shannu137/Thesis/data_Jun_2025/new_wheel/Analysis.pptx

## 0 deg

## 2 deg

## 4 deg

## 6 deg

## 8 deg

## 10 deg

## Average Slipratio for Wheel-v2

0 deg -> 0.207
2 deg -> 0.390
4 deg -> 0.657
6 deg -> 0.805
8 deg -> 0.837
10 deg -> 0.805

## Average Slipratio for Wheel-v1

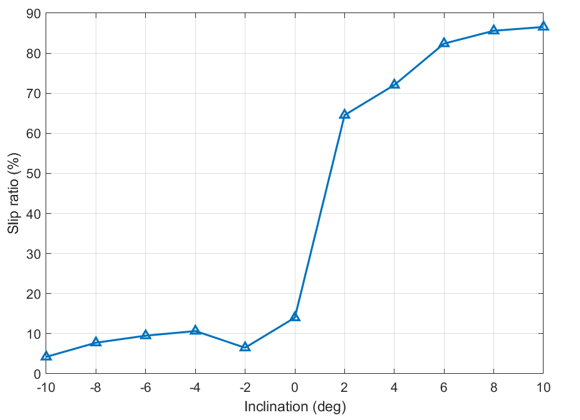
[picture p7: figure]

0 deg -> 0.135
2 deg -> 0.648
4 deg -> 0.724
6 deg -> 0.771
8 deg -> 0.806
10 deg -> 0.847
