shannu137/Thesis/SW_Testbed/sensor_specs_volt_curr.xlsx

Sensor | Quantity | Voltage | Current
Cytron Motor Driver | 3 | 5V-25V | 10A (continuous) - 30A (peak)
Johnson Motor | 6 | 12V | 7.5A
INA219 | 6 | 5V | 5mA | 30mA
Teensy Micro-controller | 2 | 5V | ~100mA | ~200mA
TCA9548A Multiplexer | 2 | 5V | 100mA | 200mA
AS5600 | 4 | 3.3V (can support 5V also) | 100mA | 400mA
IMU SmartElex 9DOF | 1 | 3.3V | 70mA | 70mA
Servo | 6 | 8.4V | 6.2A
 | 3.3V | 611mA | with 30% margin
 | 5V | 559mA
