shannu137/Thesis/SW_Testbed/optical_flow.csv

frame_number | velocity_x | velocity_y
1 | 0.0074168555 | 0.006041301
2 | -0.0014920942 | 0.0014350052
3 | -0.005337063 | 0.0058332244
4 | 0.005531667 | -0.0026308196
5 | 0.0067483163 | -0.005595006
6 | -0.0026734027 | -0.00080596143
7 | 0.004539009 | -0.00075796916
8 | -0.008693052 | -0.0005368673
9 | 0.0011223872 | 0.006953444
10 | -0.0030819236 | 0.0032837992
11 | -0.005016383 | -0.008562224
12 | 0.005270072 | 0.00051131716
13 | 0.0023588724 | 0.0044594766
14 | 0.0033568419 | -0.003661978
15 | -0.008163106 | -0.0075675035
16 | 0.004476524 | 0.0038477816
17 | -0.0005702197 | -0.0024500259
18 | 0.0011810934 | 0.010627566
19 | -0.009590522 | -0.004309468
20 | 0.0027404008 | -0.0025695295
21 | -0.0048316834 | 0.0055362284
22 | 0.0068421783 | 0.0026240353
23 | -0.013946079 | 0.0012911822
24 | -0.03017367 | 0.0053393077
25 | -0.044709574 | 0.029400552
26 | 0.5960899 | 0.03549315
27 | 5.299601 | 0.14607295
28 | 5.698839 | 0.371147
29 | 1.5077586 | 0.6525878
30 | 4.0798526 | 0.3129727
31 | 6.6240425 | 1.2050517
32 | 6.4425774 | 0.63424236
33 | 7.8483195 | 1.3951945
34 | 8.883261 | 1.123291
35 | 11.172264 | -3.1434278
36 | 11.973316 | 0.14885277
37 | 14.198208 | -0.7933853
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
