shannu137/Thesis/Communication/rover_fmeca.xlsx

Failure Mode Effects and Criticality Analysis (FMECA) |  |  |  |  |  |  |  |  |  |  |  |  |  |  |  | Severity Classification Legend |  |  | Probability Number Legend |  | CN | Frequency
Product: Planetary Rover |  |  |  | System: |  |  |  | Subsystem: Locomotion control and Communication |  |  |  |  |  | Date: 24-01-2026 | Version: v1 | Catastrophic | 4 | Loss of control, potential damage, mission abort | 1 | Very unlikely (< 0.001) | 12 | 6
Ident. Number | Item/Block | Function | Failure Mode | Failure Cause | Mission Phase / Op. Mode | Failure Effects (a. Local, b. End) | Severity Classification | Failure Detection Method | Compensating Provisions | Severity Number (SN) | Probability Number (PN) | Criticality Number (CN) | Recommendations | Remarks | Remarks on implementation | Critical | 3 | Major function loss, significant performance degradation, safety risk | 2 | Unlikely (0.001 - 0.01) | 9 | 11
COMM-001 | UART/USB Link (Teensy-Jetson) | Bidirectional telemetry and command | Complete communication loss | Cable disconnection, connector failure, EMI | ALL MODES | a. No telemetry, no commands b. Loss of control, rover immobilized | Catastrophic | Communication timeout, heartbeat loss | Watchdog triggers ESTOP on both sides | 4 | 3 | 12 | Redundant comm link, shielded cables, periodic heartbeat | Critical for slip mitigation | Periodic HB, watchdog | Marginal | 2 | Minor performance degradation, workaround available | 3 | Possible (0.01 - 0.1) | 8 | 21
COMM-002 | UART/USB Link | Bidirectional telemetry and command | Intermittent packet loss | Loose connection, EMI bursts, buffer overflow | NOMINAL, DEGRADED | a. Stale data, command dropout b. Jerky motion, incorrect slip estimation | Critical | Packet sequence number gaps, CRC failures | Retransmit, use last valid data with timeout | 3 | 4 | 12 | Implement CRC, sequence numbers, ack protocol | Affects slip calc accuracy | 1. CRC, seq nos, ack protocol 2. Retransmit last data if pkt loss | Negligible | 1 | Minimal impact, no operational effect | 4 | Likely (0.1 - 0.3) | 6 | 22
COMM-003 | UART/USB Link | Bidirectional telemetry and command | Data corruption | Bit flips, noise, baud rate mismatch | ALL MODES | a. Invalid sensor readings, wrong commands b. Erratic motor control, false slip detection | Critical | Checksum/CRC mismatch, out-of-range values | Discard corrupted packets, request retransmit | 3 | 3 | 9 | CRC-16 or higher, data validation | Can trigger false ESTOP | CRC-16/higher, discard corrupted pkt, request retransmit | Criticality Number (CN = SN × PN) |  | Higher number = Higher criticality | 5 | Very likely (> 0.3) | 10 | 3
COMM-004 | UART/USB Link | Bidirectional telemetry and command | High latency (>100ms) | CPU overload, USB stack delays, OS scheduling | NOMINAL | a. Delayed feedback b. Control lag, poor slip response | Marginal | Timestamp comparison | Increase control loop tolerance | 2 | 4 | 8 | RTOS on Teensy, real-time kernel on Jetson | Degrades slip mitigation | 1. time stamp check, if delay > threshold, latency fault flagged 2. RTOS will be implemented in next version |  |  |  |  |  | 4 | 2
COMM-005 | I2C Bus (Teensy-Current Sensors) | Read 3x current values | Bus lockup/hang | Clock stretching failure, slave not releasing SDA | NOMINAL, DEGRADED | a. Cannot read current b. No overcurrent detection, blind to motor stall | Critical | I2C timeout, bus stuck low | I2C bus reset, software recovery | 3 | 4 | 12 | Implement I2C timeout, bus recovery routine | Prevents stall detection |  |  |  |  |  |  | 3 | 1
COMM-006 | I2C Bus | Read 3x current values | Address conflict | Multiple sensors same address, PCB routing error | INIT, ALL MODES | a. Wrong sensor data read b. Incorrect current readings, false slip | Critical | Inconsistent readings, device enumeration fail | Verify addresses at boot | 3 | 2 | 6 | Verify unique I2C addresses in hardware | Design verification | Will be done during design
COMM-007 | I2C Bus | Read 3x current values | Bit errors | EMI, capacitance, long traces | NOMINAL | a. Corrupted current value b. False overcurrent or undercurrent | Marginal | Out-of-range values, checksum if available | Discard outliers, median filter | 2 | 4 | 8 | Short traces, pull-up optimization, shielding | Slip calc uses current | In Jetson check out of range for current sensor values, vel/encoder pos too
ENC-001 | Encoder (x3 per Teensy) | Measure wheel position/velocity | No signal (both channels) | Encoder failure, cable break, power loss to encoder | NOMINAL | a. Zero velocity reading b. Wheel appears stopped, false slip detection | Critical | Zero count change despite motor command | Switch to model-based estimation, DEGRADED mode | 3 | 3 | 9 | Redundant velocity estimation (current-based) | Critical for slip | If encoder failure --> meaning zero velocity despite change in motor cmd --> "DEGRADED" mode --> switch to other methods of vel estimation
ENC-002 | Encoder | Measure wheel position/velocity | Single channel failure | Partial encoder failure, A or B channel broken | NOMINAL | a. Loss of direction, reduced resolution b. Incorrect velocity, wrong slip calculation | Critical | Only one edge detected, direction ambiguity | Use single channel with last known direction | 3 | 3 | 9 | Monitor both channels, flag single-channel mode | Reduces slip accuracy | Next version
ENC-003 | Encoder | Measure wheel position/velocity | Missed counts (dropouts) | Interrupt overload, ISR too slow, debounce issues | NOMINAL, HIGH SPEED | a. Undercounted position b. Lower velocity reading, false high slip | Critical | Velocity discontinuities, acceleration limits | Limit max velocity, optimize ISR | 3 | 4 | 12 | Fast ISR, hardware quadrature decoder, DMA | Directly affects slip calc | Next version
ENC-004 | Encoder | Measure wheel position/velocity | False counts (noise) | EMI from motor PWM, poor shielding, bouncing | NOMINAL | a. Overcounted position b. Higher velocity, false low slip | Marginal | Unrealistic acceleration, velocity spikes | Digital filtering, debounce | 2 | 4 | 8 | Shielded encoder cables, RC filtering, twisted pairs | Common in PWM environment | Low Pass Filter is implemented
ENC-005 | Encoder | Measure wheel position/velocity | Phase shift/jitter | Mechanical misalignment, bearing wear, vibration | NOMINAL | a. Noisy velocity signal b. Jittery velocity, unstable slip estimate | Marginal | High velocity variance, FFT analysis | Low-pass filter, mechanical inspection | 2 | 3 | 6 | Proper encoder mounting, damping | Testbed vibration | Low Pass Filter is implemented
ENC-006 | Encoder | Measure wheel position/velocity | Mechanical decoupling | Loose set screw, shaft slip, broken coupling | NOMINAL | a. Encoder stops, wheel continues b. Zero velocity with motor running, max slip indication | Critical | Velocity drops to zero with current draw | Immediate ESTOP, mechanical inspection | 3 | 2 | 6 | Loctite on set screws, periodic inspection | Catastrophic for slip | Encoder stops, wheel moves --> ESTOP
CS-001 | Current Sensor (x3 per Teensy) | Measure motor current | No output / open circuit | Sensor failure, trace break, solder joint failure | NOMINAL | a. Zero or max reading b. No load monitoring, cannot detect stall/slip via current | Critical | Constant zero or rail value | Use voltage-based estimation, DEGRADED mode | 3 | 2 | 6 | Periodic sensor validation, redundant sensing | Stall = high slip | 1. constant zero value of current sensor --> "DEGRADED" mode 2. Think of redundancy
CS-002 | Current Sensor | Measure motor current | Offset drift | Temperature, aging, component tolerance | NOMINAL, EXTENDED OPS | a. Constant bias in reading b. Incorrect load estimation, slip calc error | Marginal | Baseline shift when motor off | Auto-zero calibration at IDLE | 2 | 4 | 8 | Auto-calibration routine, temp compensation | Lunar temp extremes | Moniter motor values when motor is off --> Auto Zero Calibration
CS-003 | Current Sensor | Measure motor current | Gain error | Wrong amplifier gain, reference voltage drift | NOMINAL | a. Scaled current reading b. Proportional error in load, slip estimation | Marginal | Cross-check with expected current model | Calibration with known loads | 2 | 3 | 6 | Factory calibration, validation test | Systematic error
CS-004 | Current Sensor | Measure motor current | Noise/spikes | PWM switching noise, inadequate filtering | NOMINAL | a. Noisy current signal b. Unstable control, false transient detection | Marginal | High frequency content in signal | Hardware RC filter, software median filter | 2 | 5 | 10 | PCB layout optimization, filtering capacitors | High PN due to PWM | Need filter for current sensor too?
CS-005 | Current Sensor | Measure motor current | Saturation | Overcurrent beyond sensor range | NOMINAL (HIGH LOAD) | a. Clipped reading b. Cannot detect true overcurrent, missed stall | Critical | Reading stuck at max | Hardware overcurrent protection on driver | 3 | 3 | 9 | Select sensor with adequate range, hardware protection | Stall during slip | Done during sensor selection
CS-006 | Current Sensor | Measure motor current | I2C communication failure (if digital sensor) | Address error, bus issue, sensor hang | NOMINAL | a. Stale/no current data b. Blind to motor load changes | Critical | I2C read timeout, NACK | I2C recovery, sensor reset | 3 | 4 | 12 | See COMM-005 mitigations | If using digital sensors | I2C read timeout, NACK --> sensor reset in next version
MD-001 | Motor Driver (x3 per Teensy) | Convert PWM to motor power | No output | Driver failure, thermal shutdown, enable pin issue | NOMINAL | a. Motor stops b. Wheel immobilized, mission abort | Critical | Zero current with PWM command | Switch to SAFE mode, diagnose other side | 3 | 2 | 6 | Thermal monitoring, enable line verification | Single wheel critical | Zero current with PWM command --> switch to SAFE mode
MD-002 | Motor Driver | Convert PWM to motor power | Stuck ON | MOSFET short, driver IC failure | NOMINAL | a. Motor runs uncontrolled b. Runaway wheel, potential damage, loss of control | Catastrophic | Current without PWM command, velocity mismatch | Hardware ESTOP, cut power via relay if available | 4 | 1 | 4 | Hardware watchdog, independent ESTOP circuit | Highest priority | Current with zero PWM, velocity mismatch between cmd vs observed --> ESTOP (check if we can stop power supply)
MD-003 | Motor Driver | Convert PWM to motor power | Reduced output / degraded | Partial MOSFET failure, overheating, voltage drop | NOMINAL | a. Lower motor power b. Reduced max velocity, asymmetric drive | Marginal | Lower velocity than commanded, higher current | Reduce speed command, thermal monitoring | 2 | 3 | 6 | Thermal sensors on drivers, derating | Gradual degradation | low velocity than commanded velocity, high current --> reduce speed cmd
MD-004 | Motor Driver | Convert PWM to motor power | PWM signal not received | Broken trace, MCU pin failure, PCB fault | NOMINAL | a. No motor control b. Wheel dead, mission abort if critical wheel | Critical | Zero velocity, zero current | Diagnose, switch to SAFE | 3 | 2 | 6 | PWM signal integrity test at INIT | PCB quality critical | zero current, zero velocity --> switch to SAFE
MD-005 | Motor Driver | Convert PWM to motor power | Direction control failure | H-bridge fault, direction pin stuck | NOMINAL | a. Wrong direction or brake b. Wheel fights command, high slip | Critical | Velocity opposite to command, high current | ESTOP, SAFE mode | 3 | 2 | 6 | Direction feedback verification | Dangerous | velocity opposite to cmd velocity, high current --> ESTOP
SERVO-001 | Servo (x3 per Teensy) | Steering/articulation control | No response | Servo failure, power loss (7.5V buck), signal issue | NOMINAL | a. Fixed steering angle b. Cannot adjust for slip, directional control loss | Critical | Angle feedback unchanged with command | Lock to safe angle, reduce speed | 3 | 2 | 6 | Angle feedback verification, power monitoring | Slip mitigation needs steering | 1. No servo feedback 2. no change in servo feedback with cmd --> lock to safe angle
SERVO-002 | Servo | Steering/articulation control | Jittering/oscillation | Noisy control signal, servo instability, mechanical binding | NOMINAL | a. Unstable angle b. Vibration, poor traction, increased slip | Marginal | High frequency angle changes, current spikes | Filter command, reduce gain | 2 | 4 | 8 | Clean PWM signal, mechanical inspection | Testbed vibration | 1. No servo feedback 2. Filter servo cmds
SERVO-003 | Servo | Steering/articulation control | Slow response | Servo overload, low voltage, mechanical resistance | NOMINAL | a. Delayed angle change b. Sluggish slip response, control lag | Marginal | Angle lags command significantly | Reduce command rate, check load | 2 | 3 | 6 | Verify servo sizing, power supply adequacy | Lunar regolith resistance | 1. No servo feedback 2. Angle lags cmd --> latency flag falagged, reduce cmd rate
SERVO-004 | Servo | Steering/articulation control | Angle feedback error | Potentiometer wear, ADC noise, calibration drift | NOMINAL | a. Wrong angle reading b. Incorrect steering, poor slip compensation | Marginal | Angle mismatch with expected, cross-check with other sensors | Recalibration routine | 2 | 4 | 8 | Periodic calibration, analog filtering | Analog signal vulnerable | 1. No servo feedback 2. angle mismatch, check with other sensors --> SAFE
SERVO-005 | Servo | Steering/articulation control | Mechanical jam | Foreign object, gear failure, bearing seizure | NOMINAL | a. Servo stalled, high current b. Fixed angle, loss of steering control | Critical | High servo current, no angle change | ESTOP, clear obstruction | 3 | 2 | 6 | Mechanical protection, current monitoring | Testbed debris
MOTOR-001 | DC Motor (x3 per Teensy) | Drive wheels | Winding open circuit | Brush wear, winding failure, connection break | NOMINAL | a. No rotation b. Wheel dead, asymmetric drive, high slip on other wheels | Critical | Zero velocity with current command, no current draw | Compensate with other wheels, DEGRADED mode | 3 | 2 | 6 | Brush inspection, connection integrity | Wear item | Nonzero cmd, zero current and velocity --> DEGRADED mode
MOTOR-002 | DC Motor | Drive wheels | Winding short circuit | Insulation failure, overheating | NOMINAL | a. High current, low torque b. Overcurrent trip, wheel ineffective | Critical | Very high current, low velocity | Current limit, thermal shutdown | 3 | 1 | 3 | Thermal protection, current limiting | Overheat in stall | High current, low velocity --> SAFE mode
MOTOR-003 | DC Motor | Drive wheels | Bearing seizure | Contamination, wear, lack of lubrication | NOMINAL | a. Motor stalls b. Wheel locked, high slip, potential damage | Critical | High current, zero velocity | ESTOP, mechanical inspection | 3 | 2 | 6 | Sealed bearings, periodic maintenance | Lunar dust | High current, zero velocity --> ESTOP
MOTOR-004 | DC Motor | Drive wheels | Reduced efficiency | Brush wear, bearing friction, magnet degradation | NOMINAL | a. Higher current for same speed b. Reduced performance, thermal issues | Marginal | Current increase over time for same velocity | Adjust control parameters, plan maintenance | 2 | 4 | 8 | Performance monitoring, predictive maintenance | Gradual degradation
MOTOR-005 | DC Motor | Drive wheels | Mechanical decoupling from wheel | Gearbox failure, shaft break, coupling failure | NOMINAL | a. Motor spins, wheel doesn't b. Zero traction, max slip, mission abort | Catastrophic | High velocity reading (encoder on motor side) with no rover motion | Immediate ESTOP | 4 | 1 | 4 | Robust mechanical design, periodic inspection | Catastrophic failure | High velocity, no rover movement --> ESTOP
MCU-001 | Teensy MCU | Control loop, sensor interface, communication | Complete failure | Power loss, firmware crash, hardware failure | ALL MODES | a. No control, no telemetry b. Half rover dead (3 wheels), mission abort | Catastrophic | No heartbeat, no telemetry | Jetson detects timeout, ESTOP, use other Teensy if possible | 4 | 2 | 8 | Watchdog timer, redundant Teensy, robust power | Critical single point | No HB or telemetry --> ESTOP (/ DEGRADED)
MCU-002 | Teensy MCU | Control loop execution | Firmware hang/deadlock | Software bug, infinite loop, resource contention | NOMINAL | a. Control stops b. Motors continue last command until watchdog | Critical | Telemetry stops, heartbeat loss | Watchdog reset, ESTOP | 3 | 3 | 9 | Watchdog timer, defensive programming, testing | Software quality critical | Use watchdog to check no deadlocks
MCU-003 | Teensy MCU | Interrupt handling | Interrupt overload | Too many encoder edges, high PWM frequency | NOMINAL (HIGH SPEED) | a. Missed interrupts, slow response b. Inaccurate encoder counts, control lag | Marginal | Increased loop time, missed counts | Reduce interrupt frequency, optimize ISR | 2 | 4 | 8 | Hardware quadrature decoder, DMA, profiling | High speed issue
MCU-004 | Teensy MCU | ADC conversion (servo feedback) | ADC failure | Hardware fault, reference voltage issue | NOMINAL | a. Invalid servo angle readings b. Incorrect steering control | Critical | Constant or erratic ADC values | Use commanded angle (open loop), DEGRADED | 3 | 2 | 6 | ADC self-test at INIT, reference monitoring | Servo feedback lost | Already added
MCU-005 | Teensy MCU | PWM generation | PWM output failure | Timer failure, pin configuration error | NOMINAL | a. No motor control b. Wheels dead, mission abort | Catastrophic | No motor response, zero current | SAFE mode, diagnose | 4 | 2 | 8 | PWM self-test at INIT, redundant timers | Critical function | Already added
MCU-006 | Teensy MCU | Memory corruption | Bit flip (radiation), buffer overflow, wild pointer | Radiation in space | ALL MODES | a. Unpredictable behavior b. Erratic control, potential damage | Critical | Checksum failure, invalid values, watchdog | Memory protection, ECC if available, watchdog | 3 | 2 | 6 | Code review, static analysis, memory bounds checking |  | Already added
CTRL-001 | PI Controller | Motor velocity control | Integral windup | Sustained error, saturation, long startup | INIT, NOMINAL | a. Overshoot, oscillation b. Unstable motion, poor slip control | Marginal | Large overshoot, oscillation in velocity | Anti-windup, integrator clamping | 2 | 4 | 8 | Implement anti-windup, conditional integration | Common PI issue | Anti-windup in PI controller
CTRL-002 | PI Controller | Motor velocity control | Tuning instability | Wrong gains, load changes, surface variation | NOMINAL | a. Oscillation or sluggish response b. Poor velocity tracking, inaccurate slip | Marginal | Velocity oscillation, steady-state error | Adaptive tuning, gain scheduling | 2 | 4 | 8 | Systematic tuning procedure, field testing | Lunar surface variation | Adaptive gains in PI controller
CTRL-003 | PI Controller | Motor velocity control | Feedforward mismatch | Incorrect model, load estimation error | NOMINAL | a. Tracking error b. Velocity lag, slip calculation error | Marginal | Persistent tracking error | Update feedforward model | 2 | 4 | 8 | Model identification, online adaptation | Model-based component | Adaptive feedforward gain
CTRL-004 | Low-Pass Filter | Velocity filtering | Cutoff too low | Conservative design, wrong parameter | NOMINAL | a. Excessive phase lag b. Delayed slip detection, slow response | Marginal | Lagging velocity signal | Increase cutoff frequency | 2 | 3 | 6 | Filter design analysis, frequency response testing | Trade-off: noise vs lag | During filter design, note this
CTRL-005 | Low-Pass Filter | Velocity filtering | Cutoff too high | Aggressive design, wrong parameter | NOMINAL | a. Noisy velocity signal b. Noisy slip estimate, false alarms | Marginal | High frequency noise in output | Decrease cutoff frequency | 2 | 3 | 6 | Filter design analysis, noise characterization | Trade-off: noise vs lag | During filter design, note this
CTRL-006 | Control Loop | Overall velocity control | Loop timing jitter | OS scheduling, interrupt latency, CPU load | NOMINAL | a. Inconsistent control update b. Degraded performance, instability | Marginal | Variable loop period | RTOS, priority management | 2 | 4 | 8 | Real-time OS, dedicated core, profiling | Jetson timing
PCB-001 | PCB Interconnects | Electrical connections | Solder joint failure | Thermal cycling, vibration, poor soldering | NOMINAL | a. Intermittent connection b. Erratic behavior, intermittent failures | Critical | Intermittent sensor readings, random resets | Conformal coating, robust soldering | 3 | 3 | 9 | IPC standards, inspection, conformal coating | Vibration in testbed
PCB-002 | PCB Traces | Signal routing | Trace break | Mechanical stress, manufacturing defect | ALL MODES | a. Open circuit b. Component non-functional | Critical | Component failure symptoms | Redundant traces if critical | 3 | 2 | 6 | Proper PCB design, stress relief, inspection | Manufacturing quality
PCB-003 | PCB | Ground plane | Ground loop / poor grounding | Layout error, multiple ground points | NOMINAL | a. Noise injection b. Sensor noise, communication errors | Marginal | Unexplained noise, EMI issues | Star grounding, ground plane optimization | 2 | 4 | 8 | Proper PCB layout, ground plane design | Common EMI issue
PCB-004 | PCB | Power distribution | Voltage drop | Thin traces, high current, long traces | NOMINAL | a. Reduced voltage at component b. Component malfunction, brownout | Marginal | Voltage monitoring, brownout detection | Wider traces, separate power planes | 2 | 3 | 6 | Power integrity analysis, adequate trace width | High current paths
PCB-005 | PCB Connectors | Mechanical/electrical interface | Connector loosening | Vibration, thermal cycling, poor retention | NOMINAL | a. Intermittent connection b. Random failures, intermittent behavior | Critical | Intermittent failures correlated with motion | Locking connectors, strain relief, adhesive | 3 | 4 | 12 | Locking connectors, periodic inspection | High vibration
PCB-006 | PCB | ESD protection | ESD damage | Handling, dry environment, no protection | INIT, DIAGNOSTIC | a. Component damage b. Permanent failure | Critical | Component failure after handling | ESD protection devices, handling procedures | 3 | 2 | 6 | ESD protection, handling protocols | Preventive
ALGO-001 | Slip Estimation Algorithm | Calculate wheel slip | Incorrect slip calculation | Wrong formula, sensor fusion error, calibration | NOMINAL | a. Wrong slip value b. Ineffective slip mitigation, false alarms | Critical | Slip value doesn't match observed behavior | Algorithm validation, ground truth comparison | 3 | 3 | 9 | Extensive testing, validation with known conditions | Core mission function | After implementing slip control techniques
ALGO-002 | Slip Estimation Algorithm | Calculate wheel slip | Division by zero | Zero velocity reference, edge case | NOMINAL (LOW SPEED) | a. NaN or infinite slip b. Algorithm crash, control failure | Critical | Math exception, invalid values | Bounds checking, minimum threshold | 3 | 3 | 9 | Defensive programming, edge case testing | Low speed vulnerability | After implementing slip control techniques
ALGO-003 | Slip Mitigation Strategy | Adjust control for slip | Ineffective response | Wrong strategy, insufficient authority, delay | NOMINAL | a. Slip continues b. Mission inefficiency, potential immobilization | Marginal | Persistent high slip despite mitigation | Strategy refinement, increased authority | 2 | 4 | 8 | Field testing, strategy optimization | Algorithm effectiveness | After implementing slip control techniques
ALGO-004 | Slip Mitigation Strategy | Adjust control for slip | Overcorrection | Too aggressive, wrong gains | NOMINAL | a. Oscillation, instability b. Jerky motion, increased slip | Marginal | Hunting behavior, oscillation | Reduce gains, add damping | 2 | 4 | 8 | Tuning, stability analysis | Stability issue | After implementing slip control techniques
SYS-001 | Left-Right Symmetry | Independent 3-wheel control | Asymmetric failure | One Teensy fails, one side degraded | NOMINAL | a. One side functional, other not b. Rover turns, cannot go straight | Critical | Telemetry from only one Teensy | Jetson compensates with differential control if possible | 3 | 2 | 6 | Redundancy strategy, cross-side compensation | System-level | ESTOP (/ DEGRADED)
SYS-002 | Jetson | High-level control, telemetry processing | Jetson crash/hang | Software bug, OS issue, resource exhaustion | NOMINAL | a. No high-level control b. Teensys continue last command until timeout, then ESTOP | Critical | No commands from Jetson, external monitoring | Teensy watchdog triggers ESTOP | 3 | 3 | 9 | Jetson watchdog, robust software, monitoring | System-level | No cmds from Jetson --> ESTOP
SYS-003 | Jetson | Command generation | Incorrect commands | Software bug, sensor fusion error | NOMINAL | a. Wrong motor/servo commands b. Erratic motion, potential damage | Critical | Unexpected rover behavior, safety bounds violation | Sanity checks on Teensy, rate limiting | 3 | 3 | 9 | Software validation, bounds checking on both sides | Software quality | Bounds check
SYS-004 | Overall System | Slip estimation and mitigation | Sensor data synchronization error | Different sample rates, timing jitter, latency | NOMINAL | a. Misaligned sensor data b. Incorrect slip calculation, phase errors | Marginal | Timestamp analysis, correlation issues | Timestamp all data, synchronization protocol | 2 | 4 | 8 | Time synchronization, consistent sampling | Multi-sensor fusion
SYS-005 | Overall System | State machine transitions | Incorrect mode transition | Logic error, race condition, unexpected event | ALL MODES | a. Stuck in wrong mode b. Inappropriate behavior for situation | Critical | Mode doesn't match expected, telemetry monitoring | Watchdog, manual override | 3 | 3 | 9 | State machine validation, formal verification | Safety-critical
SYS-006 | Overall System | Emergency stop | ESTOP not triggered when needed | Detection failure, logic error, hardware fault | NOMINAL | a. Unsafe condition continues b. Potential damage, mission failure | Catastrophic | External observation, post-incident analysis | Multiple ESTOP triggers, hardware watchdog | 4 | 2 | 8 | Redundant ESTOP paths, independent hardware watchdog | Safety-critical
SYS-007 | Overall System | Emergency stop | False ESTOP trigger | Sensor noise, wrong threshold, software bug | NOMINAL | a. Unnecessary stop b. Mission interruption, efficiency loss | Marginal | Frequent ESTOP without real hazard | Adjust thresholds, debouncing | 2 | 4 | 8 | Threshold tuning, false alarm analysis | Nuisance vs safety
ENV-001 | All Sensors/Components | Normal operation | Lunar dust contamination | Fine regolith particles, testbed simulation | NOMINAL (EXTENDED) | a. Encoder fouling, connector issues b. Degraded performance, failures | Marginal | Performance degradation over time | Sealed components, periodic cleaning | 2 | 5 | 10 | Dust mitigation, sealed enclosures | Testbed simulation
ENV-002 | All Components | Normal operation | Temperature extremes | Testbed thermal cycling simulation | ALL MODES | a. Component out of spec b. Failures, performance degradation | Marginal | Temperature monitoring, component behavior | Thermal management, component selection | 2 | 4 | 8 | Temperature sensors, thermal design | Lunar environment
ENV-003 | All Electrical | Normal operation | Vibration | Testbed motion, mechanical coupling | NOMINAL | a. Connector loosening, solder fatigue b. Intermittent failures | Marginal | Intermittent issues during motion | Vibration damping, robust connections | 2 | 5 | 10 | Vibration isolation, robust design | Testbed characteristic
