shannu137/Thesis/Kinematics_Simulink/Rover URDF 2/meshes/trl.STL

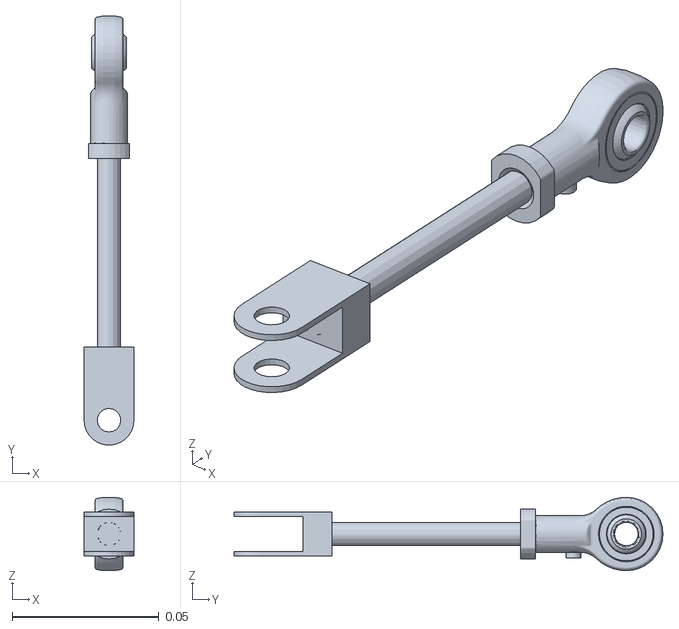
[picture p8: CAD file, 2025-11-26]
Kinematics_Simulink/Rover URDF 2/meshes/trl.STL
0.017 x 0.146 x 0.025
