shannu137/Thesis/Kinematics_Simulink/Rover URDF 2/meshes/k4.STL

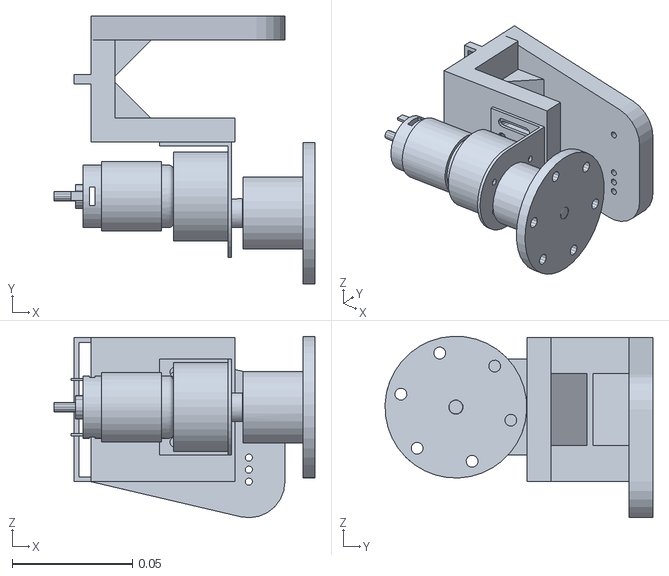
[picture p9: CAD file, 2025-11-26]
Kinematics_Simulink/Rover URDF 2/meshes/k4.STL
0.109 x 0.111 x 0.0755
