shannu137/Thesis/Kinematics_Simulink/Rover URDF 2/meshes/k5.STL

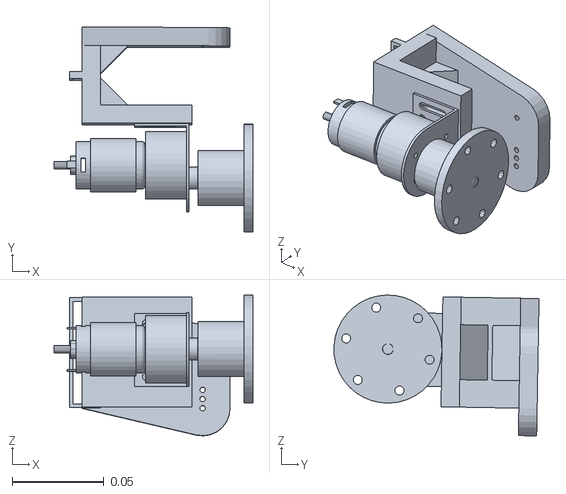
[picture p10: CAD file, 2025-11-26]
Kinematics_Simulink/Rover URDF 2/meshes/k5.STL
0.109 x 0.112 x 0.0769
