shannu137/Thesis/Kinematics_Simulink/Rover URDF 2/meshes/br.STL

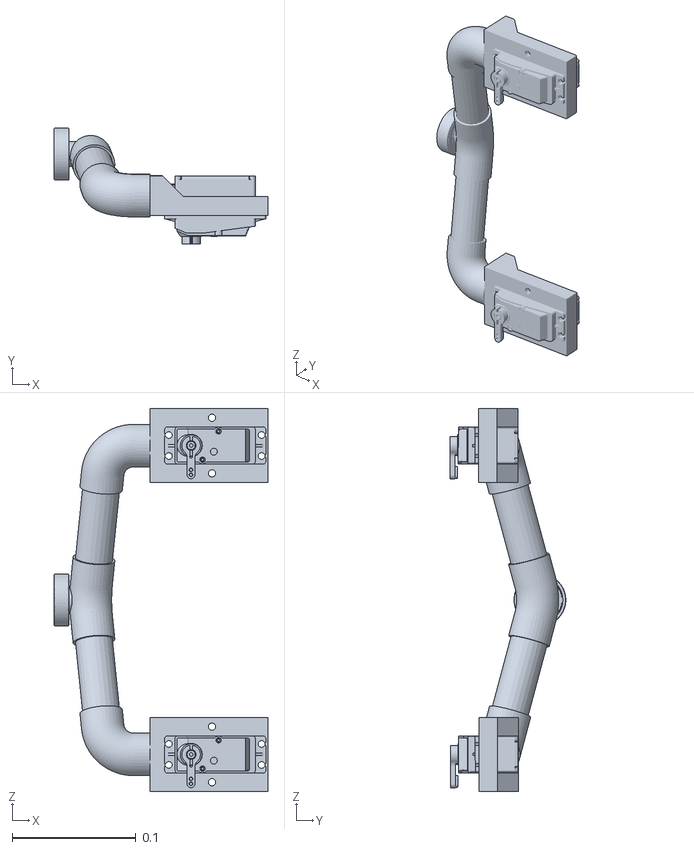
[picture p11: CAD file, 2025-11-26]
Kinematics_Simulink/Rover URDF 2/meshes/br.STL
0.173 x 0.0937 x 0.31
