shannu137/Thesis/Kinematics_Simulink/Rover URDF 2/meshes/base_link.STL

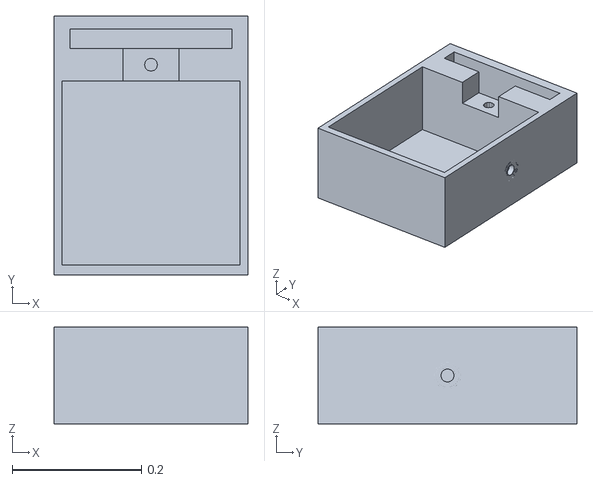
[picture p12: CAD file, 2025-11-26]
Kinematics_Simulink/Rover URDF 2/meshes/base_link.STL
0.3 x 0.4 x 0.15
