shannu137/Thesis/Kinematics_Simulink/Rover URDF 2/meshes/w5.STL

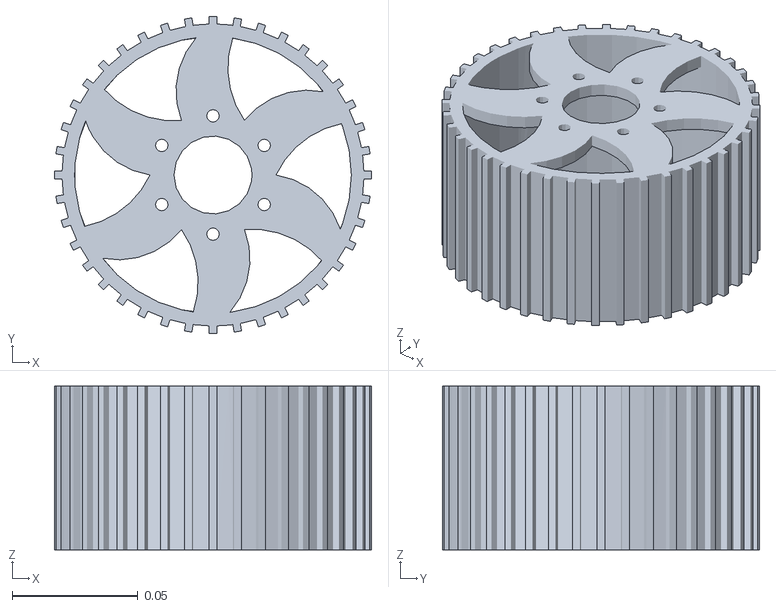
[picture p13: CAD file, 2025-11-26]
Kinematics_Simulink/Rover URDF 2/meshes/w5.STL
0.126 x 0.126 x 0.065
