shannu137/Thesis/Kinematics_Simulink/Rover URDF 2/meshes/l.STL

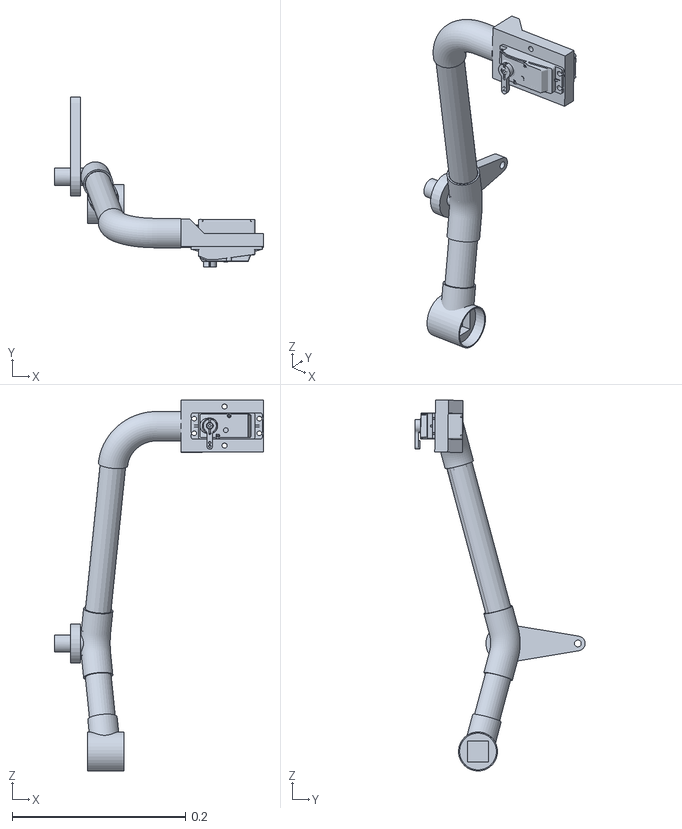
[picture p14: CAD file, 2025-11-26]
Kinematics_Simulink/Rover URDF 2/meshes/l.STL
0.241 x 0.196 x 0.428
