shannu137/Thesis/Kinematics_Simulink/Rover URDF 2/meshes/k1.STL

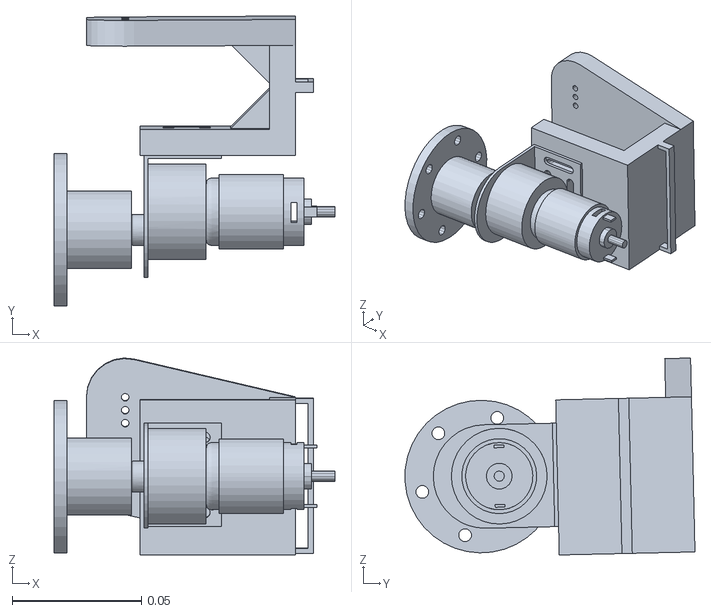
[picture p15: CAD file, 2025-11-26]
Kinematics_Simulink/Rover URDF 2/meshes/k1.STL
0.109 x 0.112 x 0.0762
