shannu137/Thesis/Kinematics_Simulink/Rover URDF 2/meshes/df.STL

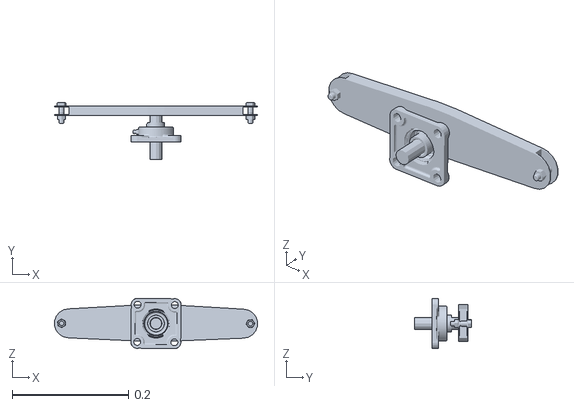
[picture p16: CAD file, 2025-11-26]
Kinematics_Simulink/Rover URDF 2/meshes/df.STL
0.349 x 0.0975 x 0.0867
