shannu137/Thesis/(list of files, cad)

Other CAD files:
Kinematics_Simulink/Rover URDF 2/meshes/trr.STL
Kinematics_Simulink/Rover URDF 2/meshes/k6.STL
Kinematics_Simulink/Rover URDF 2/meshes/k3.STL
Kinematics_Simulink/Rover URDF 2/meshes/bl.STL
Kinematics_Simulink/Rover URDF 2/meshes/w3.STL
Kinematics_Simulink/Rover URDF 2/meshes/w4.STL
Kinematics_Simulink/Rover URDF 2/meshes/r .STL
Kinematics_Simulink/Rover URDF 2/meshes/k2.STL
Kinematics_Simulink/Rover URDF 2/meshes/w1.STL
Kinematics_Simulink/Rover URDF 2/meshes/w6.STL
Kinematics_Simulink/Rover URDF 2/meshes/w2.STL
