shannu137/Thesis/data_Jun_2025/new_wheel/Analysis.pdf

# 0 deg

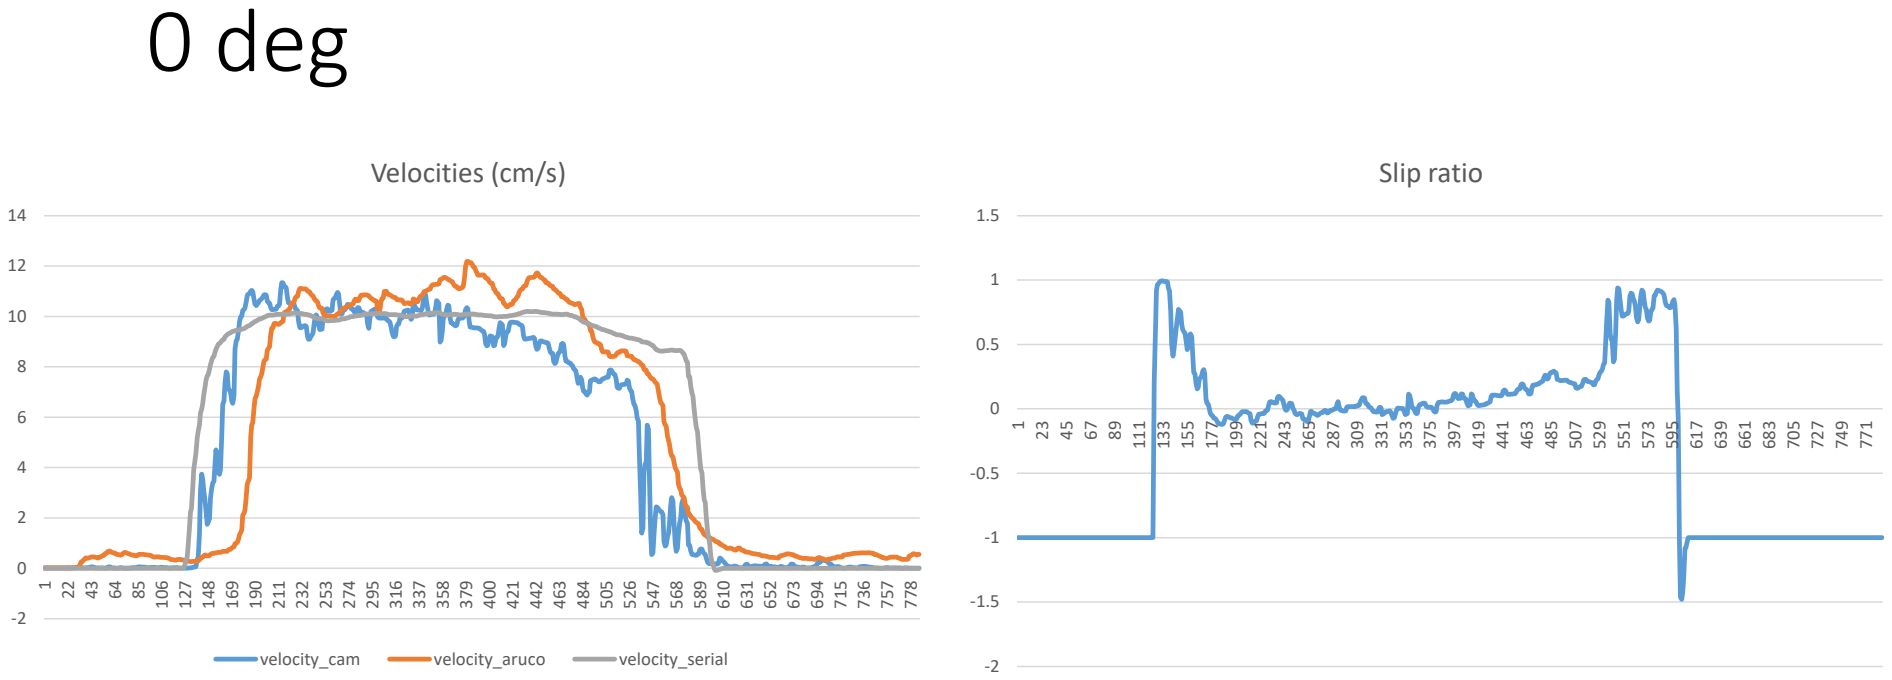
[picture p17: page 1]
Velocities (cm/s); velocity_cam; velocity_aruco; velocity_serial; Slip ratio

# 2 deg

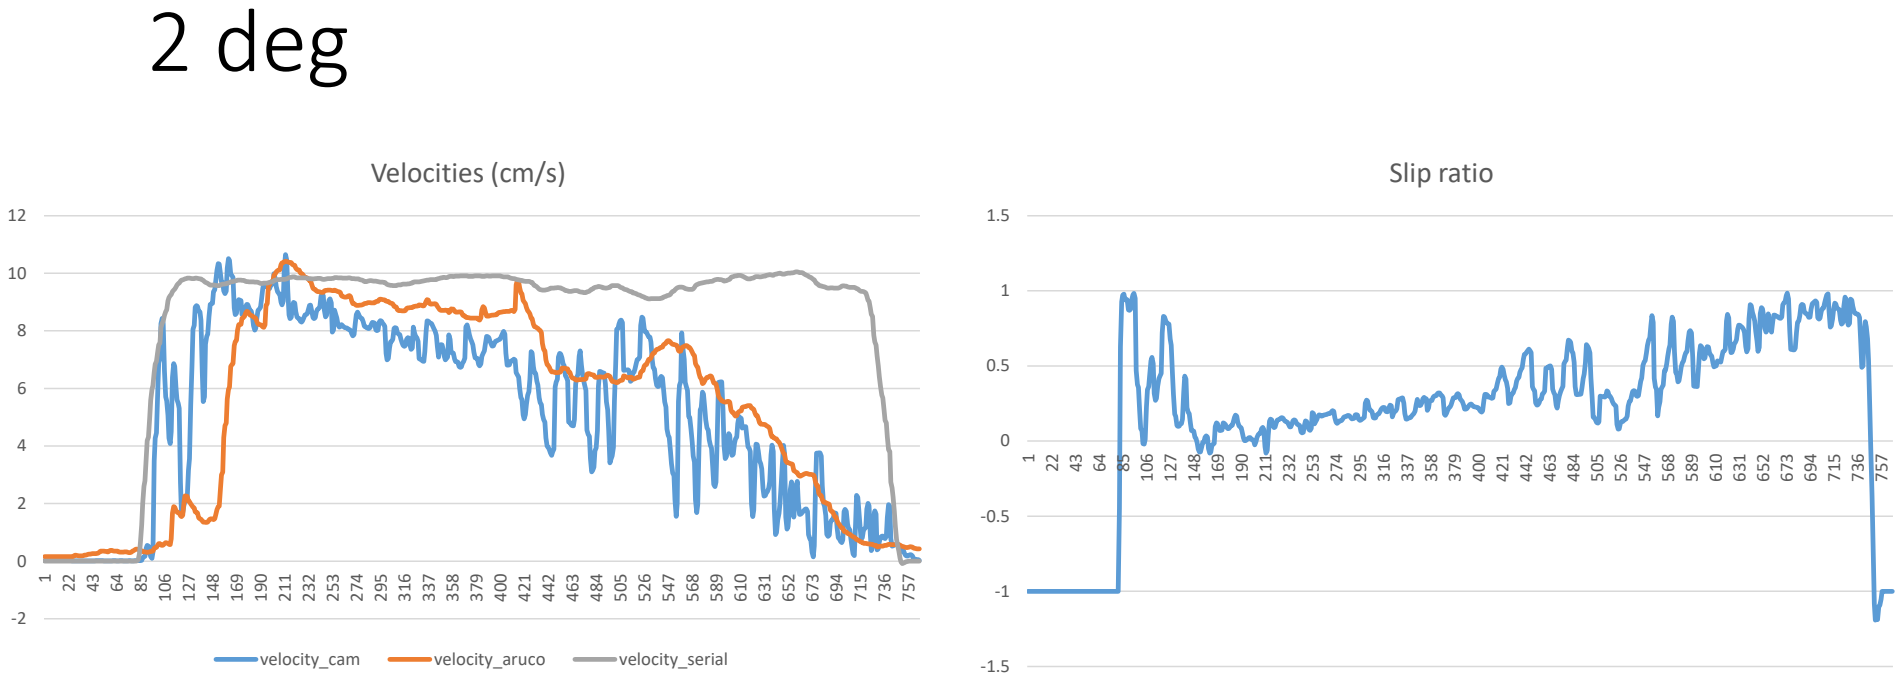
[picture p18: page 2]
Velocities (cm/s); velocity_cam; velocity_aruco; velocity_serial; Slip ratio

# 4 deg

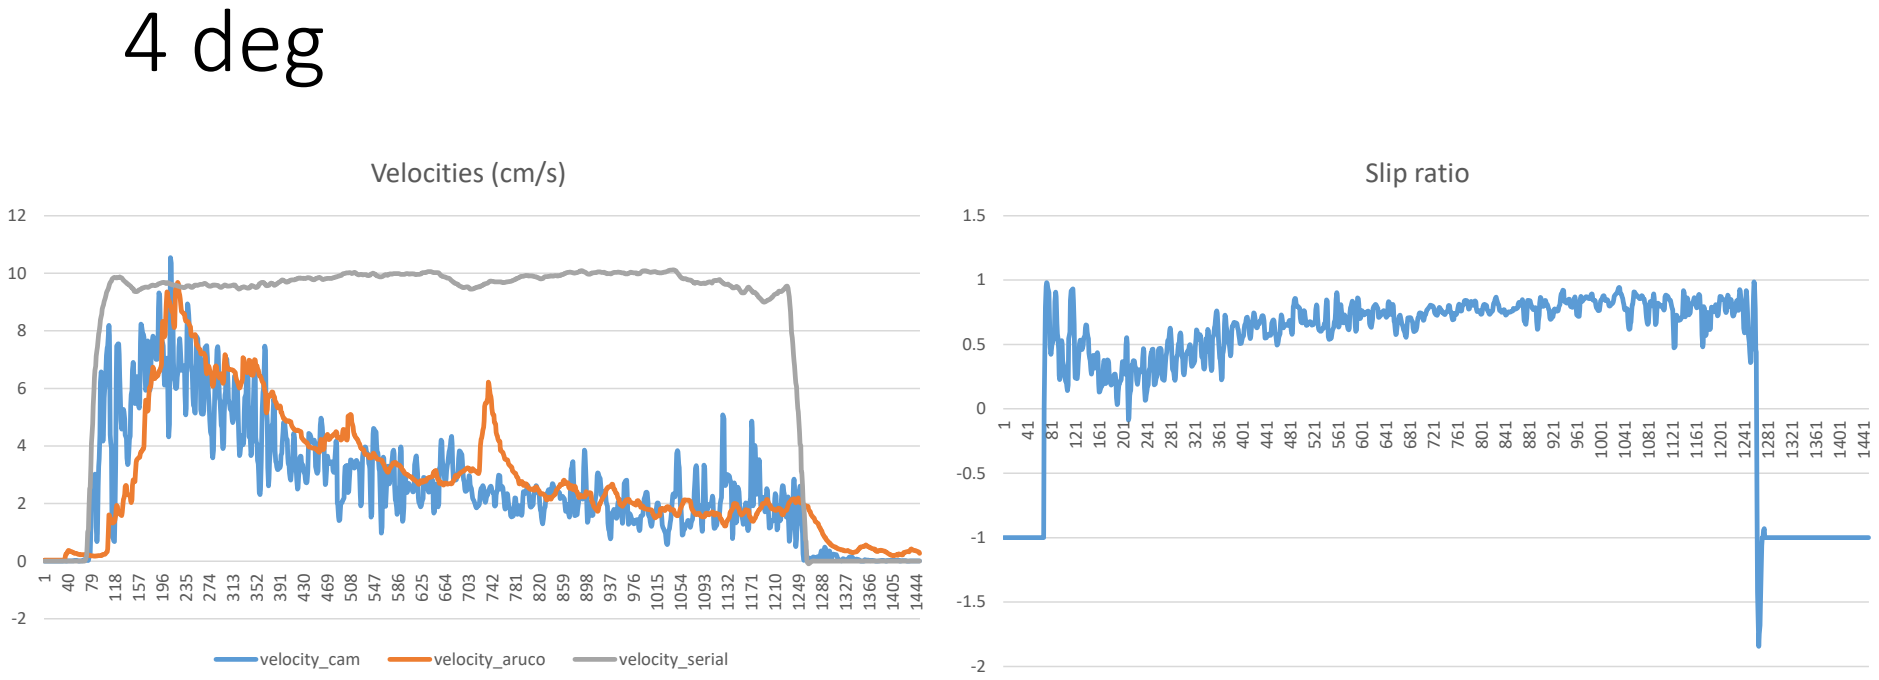
[picture p19: page 3]
Velocities (cm/s); velocity_cam; velocity_aruco; velocity_serial; Slip ratio

# 6 deg

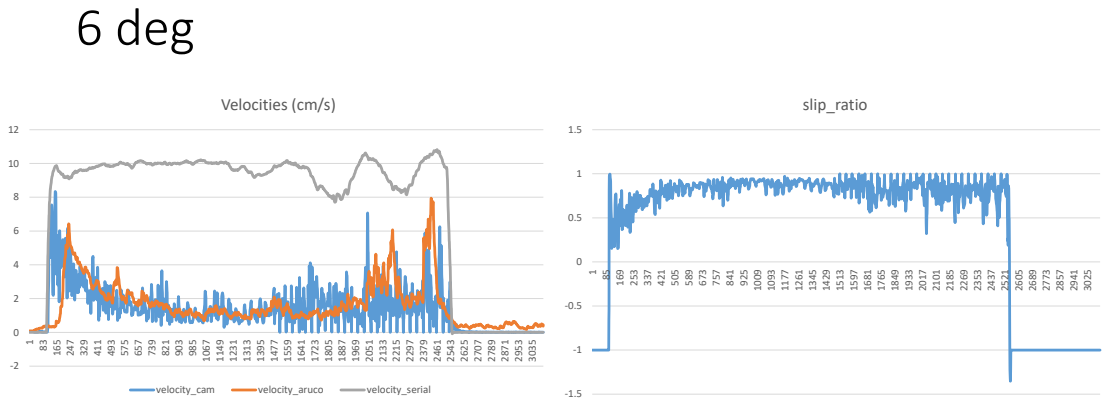
[picture p20: page 4]
Velocities (cm/s); velocity_cam; velocity_aruco; velocity_serial; slip_ratio

# 8 deg

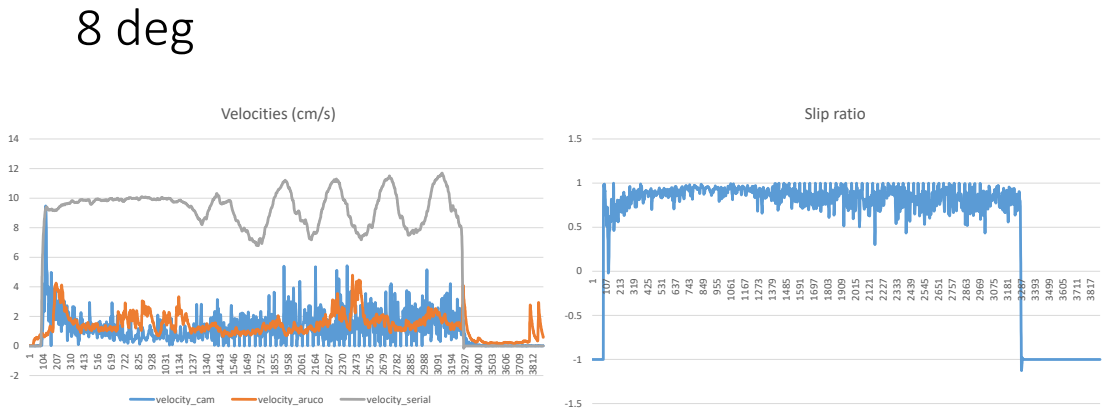
[picture p21: page 5]
Velocities (cm/s); velocity_cam; velocity_aruco; velocity_serial; Slip ratio

# 10 deg

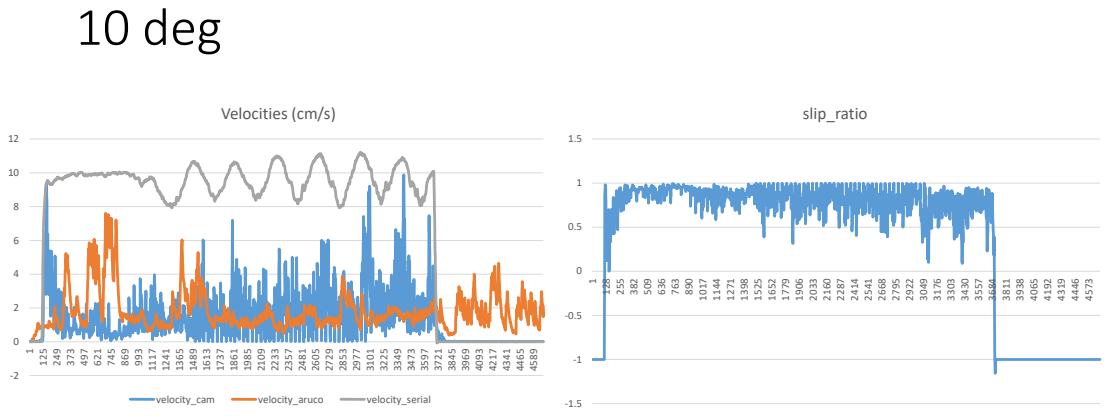
[picture p22: page 6]
Velocities (cm/s); velocity_cam; velocity_aruco; velocity_serial; slip_ratio

# Average Slipratio

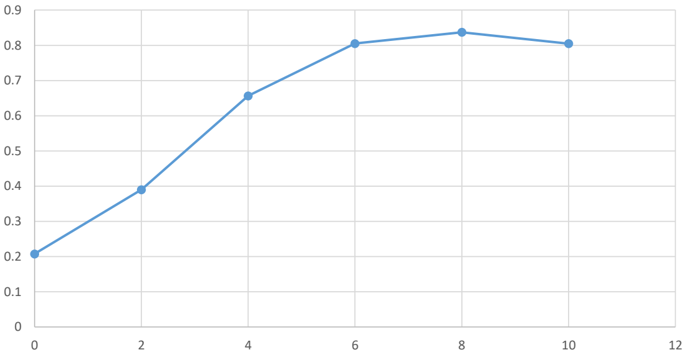
[picture p23: figure]

# 0 deg -> 0.207447 2 deg -> 0.389852 4 deg -> 0.656637 6 deg -> 0.805145 8 deg -> 0.837180 10 deg -> 0.805028

## Slip ratio vs Inclination
