shannu137/Thesis/Single_Wheel_Board_Updated/Single_Wheel_Board.kicad_pcb

## KiCad design Single_Wheel_Board_Updated/Single_Wheel_Board.kicad_pcb (2025-11-26)

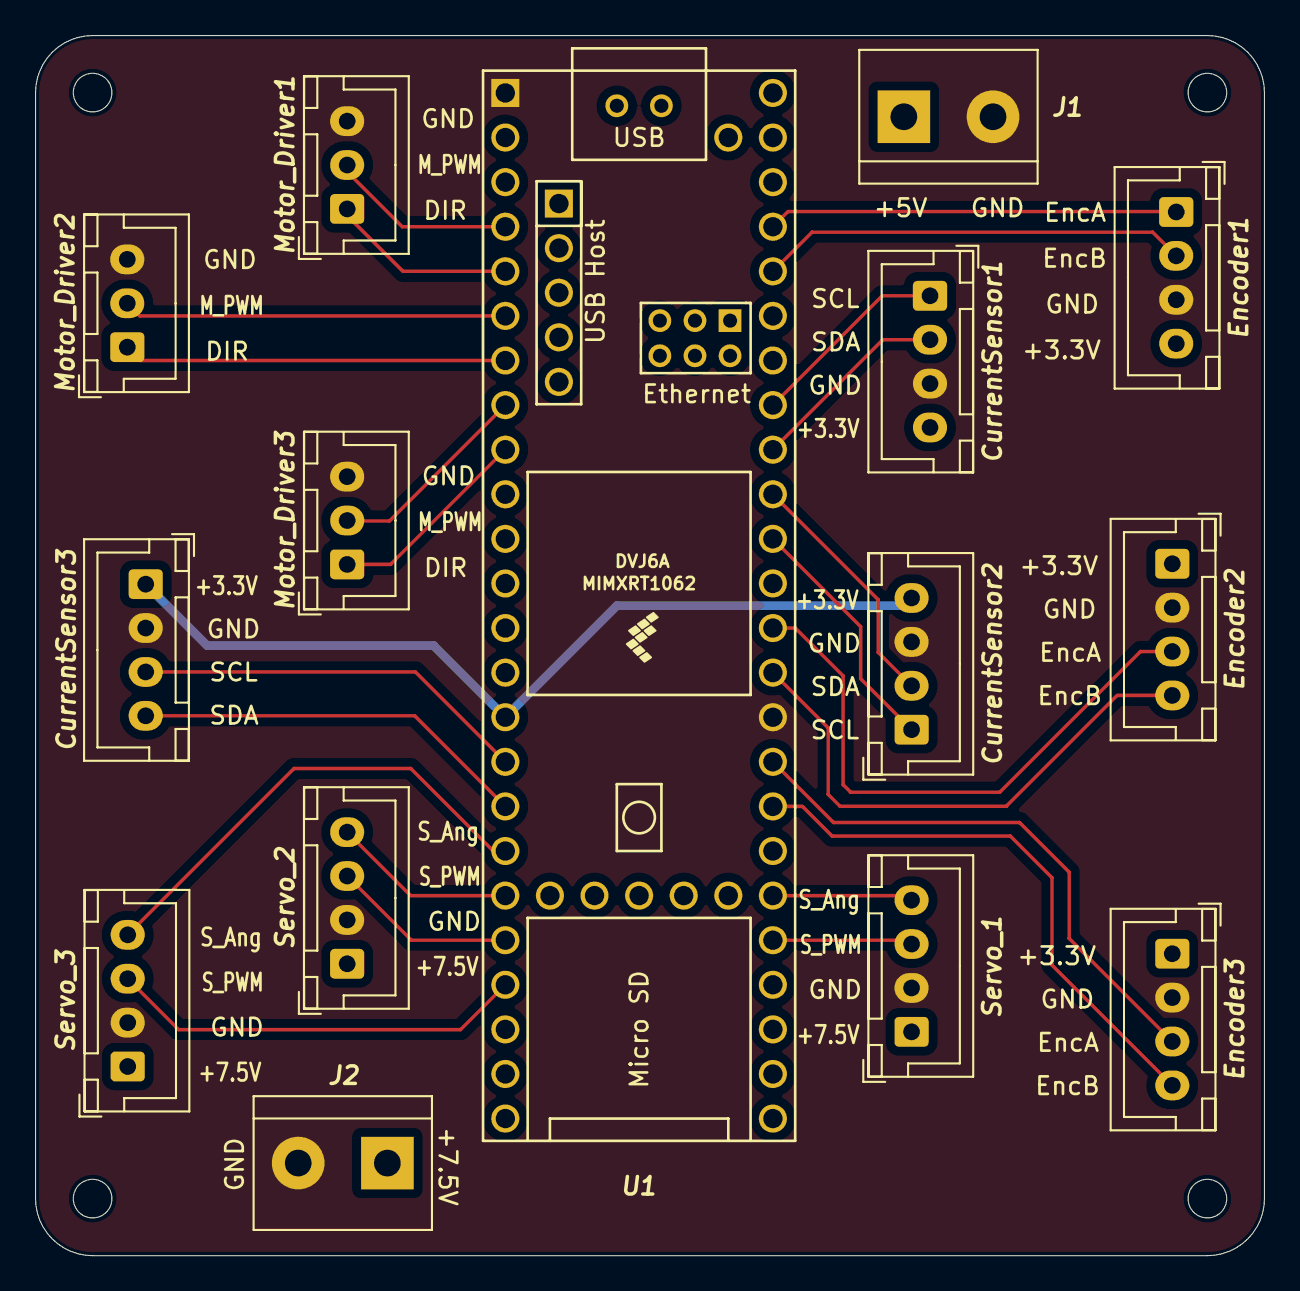
[picture p24: board Single_Wheel_Board.kicad_pcb from above]

Board: 2 copper layers, 70.0 x 69.5 mm, 15 parts (0 on the bottom side), 28 nets.

Parts:
CurrentSensor1, CurrentSensor2, CurrentSensor3: Conn_01x04; JST_XH_B4B-XH-A_1x04_P2.50mm_Vertical
Encoder1, Encoder2, Encoder3: Conn_01x04; JST_XH_B4B-XH-A_1x04_P2.50mm_Vertical
J1, J2: Screw_Terminal_01x02; TerminalBlock_bornier-2_P5.08mm
Motor_Driver1, Motor_Driver2, Motor_Driver3: Conn_01x03; JST_XH_B3B-XH-A_1x03_P2.50mm_Vertical
Servo_1, Servo_2, Servo_3: Conn_01x04; JST_XH_B4B-XH-A_1x04_P2.50mm_Vertical
U1: Teensy4.1; Teensy41

Connections:
+3.3V: CurrentSensor1.4, CurrentSensor2.4, CurrentSensor3.1, Encoder1.4, Encoder2.1, Encoder3.1, U1.15 (3V3)
+5V: J1.1, U1.48 (VIN)
+7.5V: J2.1, Servo_1.1, Servo_2.1, Servo_3.1
DIR1: Motor_Driver1.1, U1.5 (3_LRCLK2)
DIR2: Motor_Driver2.1, U1.7 (5_IN2)
DIR3: Motor_Driver3.1, U1.9 (7_RX2_OUT1A)
EncA1: Encoder1.1, U1.45 (23_A9_CRX1_MCLK1)
EncA2: Encoder2.3, U1.36 (14_A0_TX3_SPDIF_OUT)
EncA3: Encoder3.3, U1.33 (41_A17)
EncB1: Encoder1.2, U1.44 (22_A8_CTX1)
EncB2: Encoder2.4, U1.35 (13_SCK_LED)
EncB3: Encoder3.4, U1.32 (40_A16)
GND: CurrentSensor1.3, CurrentSensor2.3, CurrentSensor3.2, Encoder1.3, Encoder2.2, Encoder3.2, J1.2, J2.2, Motor_Driver1.3, Motor_Driver2.3, Motor_Driver3.3, Servo_1.2, Servo_2.2, Servo_3.2, U1.1 (GND), U1.34 (GND)
M_PWM1: Motor_Driver1.2, U1.4 (2_OUT2)
M_PWM2: Motor_Driver2.2, U1.6 (4_BCLK2)
M_PWM3: Motor_Driver3.2, U1.8 (6_OUT1D)
SCL1: CurrentSensor1.1, U1.41 (19_A5_SCL)
SCL2: CurrentSensor2.1, U1.38 (16_A2_RX4_SCL1)
SCL3: CurrentSensor3.3, U1.16 (24_A10_TX6_SCL2)
SDA1: CurrentSensor1.2, U1.40 (18_A4_SDA)
SDA2: CurrentSensor2.2, U1.39 (17_A3_TX4_SDA1)
SDA3: CurrentSensor3.4, U1.17 (25_A11_RX6_SDA2)
S_Ang1: Servo_1.4, U1.30 (38_CS1_IN1)
S_Ang2: Servo_2.4, U1.19 (27_A13_SCK1)
S_Ang3: Servo_3.4, U1.18 (26_A12_MOSI1)
S_PWM1: Servo_1.3, U1.29 (37_CS)
S_PWM2: Servo_2.3, U1.20 (28_RX7)
S_PWM3: Servo_3.3, U1.21 (29_TX7)
